markfarnan/yacht_hardware/README.md

# yacht_hardware
Various sensor circuits and boards for Yachts
