markfarnan/yacht_hardware/Multichannel_FET/FET_Multi.kicad_pcb

## KiCad design Multichannel_FET/FET_Multi.kicad_pcb (2020-11-30)

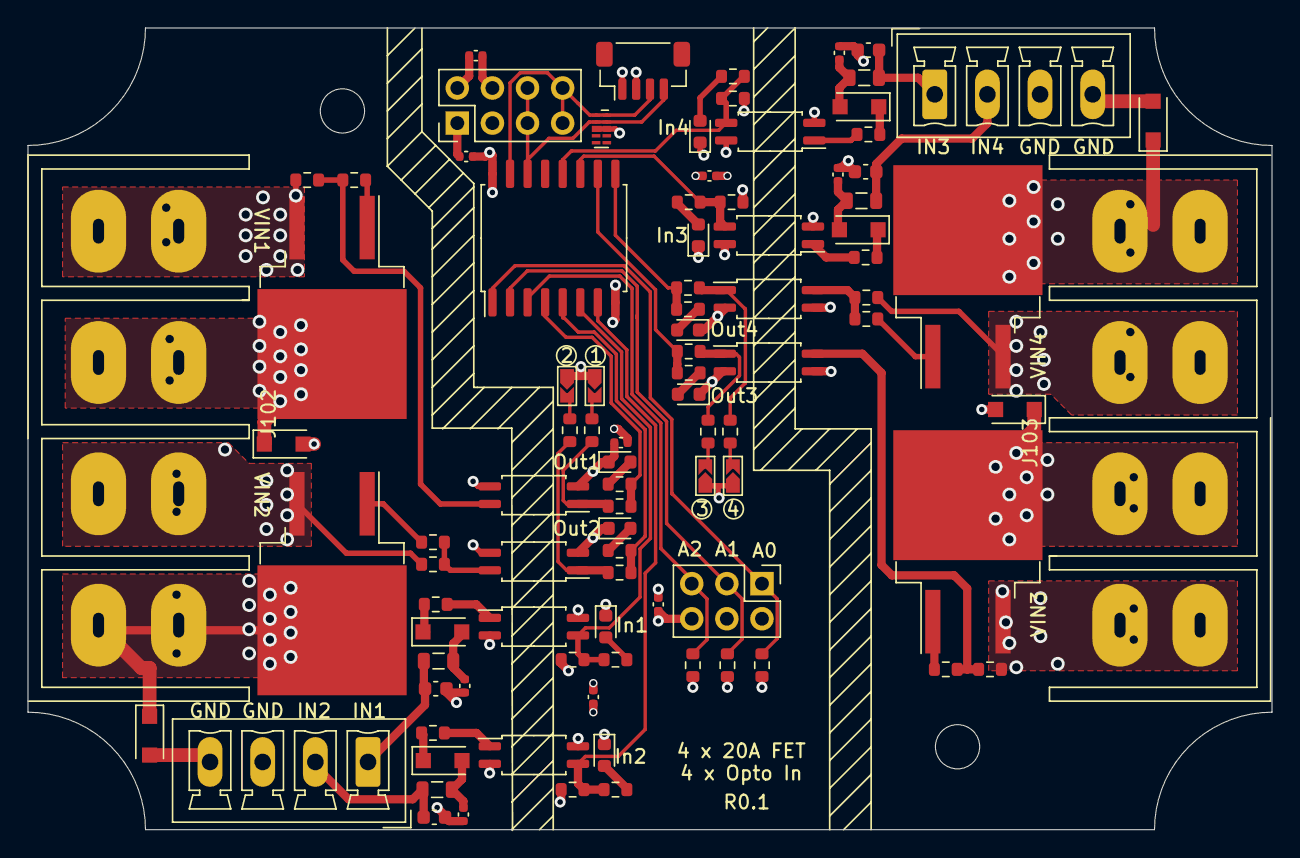
[picture p3: board FET_Multi.kicad_pcb from above]

Board: 4 copper layers, 90.0 x 58.0 mm, 96 parts (0 on the bottom side), 65 nets.

Parts:
C301, C303, C305, C307: 33pF; C_0402_1005Metric
C302, C304, C306, C308: 33pF/50V; C_0603_1608Metric
C1001, C1002, C1003, C1004, C1005, C1006: 100nF; C_0402_1005Metric
D101, D103, D105, D107, D301, D303, D305, D307: GREEN LED; LED_0603_1608Metric
D102, D104, D106, D108, D302, D304, D306, D308: SM4007PL; D_SOD-123F
FB301, FB302, FB303, FB304: GZ2012D101TF; L_0805_2012Metric
H1001, H1002: MountingHole; MountingHole_3.2mm_M3_Unplated
J101: I2C; PinHeader_2x04_P2.54mm_Vertical
J102, J103: DBT50G-9.5-4P; Connector_9.5mm_ScrewTerminal_4-Reversable
J104: Conn_01x04; JST_SH_BM04B-SRSS-TB_1x04-1MP_P1.00mm_Vertical
J106: ADDR; PinHeader_2x03_P2.54mm_Vertical
J107, J108, J109, J110: PU_ON; SolderJumper-2_P1.3mm_Open_TrianglePad_Narrow
J302, J303: MC 4; PhoenixContact_MCV_1,5_4-G-3.81_1x04_P3.81mm_Vertical
Q101, Q102, Q103, Q104: IRF5210STRLPBF; TO-263-2
R101, R105, R109, R113, R305, R307, R311, R312: 2k; R_0603_1608Metric
R102, R106, R110, R114: 220R; R_0603_1608Metric
R103, R107, R111, R115, R117, R118, R119: 10k; R_0603_1608Metric
R104, R108, R112, R116, R120, R121, R122, R123: 1k; R_0603_1608Metric
R301, R302, R303, R304, R306, R308, R309, R310: 2.2k; R_0603_1608Metric
U101, U102, U103, U104, U301, U302, U303, U304: EL3H7(C)(TA)-G; SOP-4_4.4x2.6mm_P1.27mm
U105: PCF8574T/3,518; SOIC-16W_7.5x10.3mm_P1.27mm
U106: RCLAMP0524P-N; Diodes_UDFN-10_1.0x2.5mm_P0.5mm

Connections:
+3V3: C1001.2, C1002.2, C1003.2, C1004.2, C1005.2, C1006.2, J101.3, J101.4, J104.2, J106.2, J106.4, J106.6, J107.1, J108.1, J109.1, J110.1, U105.16, U301.4, U302.4, U303.4, U304.4
/A0: J106.1, R119.1, U105.1
/A1: J106.3, R118.1, U105.2
/A2: J106.5, R117.1, U105.3
/GPIO0: R101.1, R102.2, U105.4
/GPIO1: R105.1, R106.2, U105.5
/GPIO4: R113.1, R114.2, U105.9
/GPIO5: R109.1, R110.2, U105.10
/Opto Input/ISO_IN_1: C302.1, FB301.1, J302.1
/Opto Input/ISO_IN_2: C304.1, FB302.1, J302.2
/Opto Input/ISO_IN_3: C306.1, FB303.1, J303.1
/Opto Input/ISO_IN_4: C308.1, FB304.1, J303.2
/SCL: J101.5, J101.6, J104.4, U105.14, U106.2, U106.9
/SDA: J101.7, J101.8, J104.3, U105.15, U106.1, U106.10
/VIN1: J102.1, Q101.3, R103.1
/VIN2: J102.3, Q102.3, R107.1
/VIN3: J103.1, Q103.3, R111.1
/VIN4: J103.3, Q104.3, R115.1
/VOUT1: D102.1, J102.2, Q101.2
/VOUT2: D104.1, J102.4, Q102.2
/VOUT3: D106.1, J103.2, Q103.2
/VOUT4: D108.1, J103.4, Q104.2
GND: C1001.1, C1002.1, C1003.1, C1004.1, C1005.1, C1006.1, D101.1, D103.1, D105.1, D107.1, D301.1, D303.1, D305.1, D307.1, J101.1, J101.2, J104.1, R117.2, R118.2, R119.2, R301.1, R303.1, R309.1, R310.1, U101.2, U102.2, U103.2, U104.2, U105.8, U106.3, U106.8
GND1: C301.2, C302.2, C303.2, C304.2, D102.2, D104.2, J302.3, J302.4, U101.3, U102.3, U301.2, U302.2
GND2: C305.2, C306.2, C307.2, C308.2, D106.2, D108.2, J303.3, J303.4, U103.3, U104.3, U303.2, U304.2
GPIO2: R301.2, R305.1, U105.6, U301.3
GPIO3: R303.2, R307.1, U105.7, U302.3
GPIO6: R309.2, R311.1, U105.11, U303.3
GPIO7: R310.2, R312.1, U105.12, U304.3
unnamed: C301.1, D302.2, FB301.2
unnamed: C303.1, D304.2, FB302.2
unnamed: C305.1, D306.2, FB303.2
unnamed: C307.1, D308.2, FB304.2
unnamed: D101.2, R101.2
unnamed: D103.2, R105.2
unnamed: D105.2, R109.2
unnamed: D107.2, R113.2
unnamed: D301.2, R305.2
unnamed: D302.1, R302.1
unnamed: D303.2, R307.2
unnamed: D304.1, R304.1
unnamed: D305.2, R311.2
unnamed: D306.1, R306.1
unnamed: D307.2, R312.2
unnamed: D308.1, R308.1
unnamed: J107.2, R120.1
unnamed: J108.2, R121.1
unnamed: J109.2, R122.1
unnamed: J110.2, R123.1
unnamed: Q101.1, R104.1
unnamed: Q102.1, R108.1
unnamed: Q103.1, R112.1
unnamed: Q104.1, R116.1
unnamed: R102.1, R120.2, U101.1
unnamed: R103.2, R104.2, U101.4
unnamed: R106.1, R121.2, U102.1
unnamed: R107.2, R108.2, U102.4
unnamed: R110.1, R123.2, U103.1
unnamed: R111.2, R112.2, U103.4
unnamed: R114.1, R122.2, U104.1
unnamed: R115.2, R116.2, U104.4
unnamed: R302.2, U301.1
unnamed: R304.2, U302.1
unnamed: R306.2, U304.1
unnamed: R308.2, U303.1
