markfarnan/yacht_hardware/Opto-Tacho/Opto-Tacho.kicad_pcb

## KiCad design Opto-Tacho/Opto-Tacho.kicad_pcb (2020-11-29)

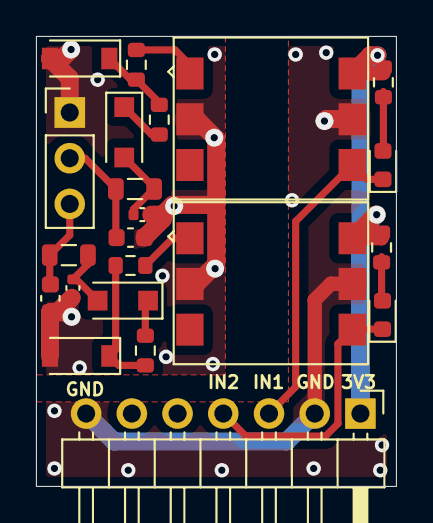
[picture p4: board Opto-Tacho.kicad_pcb from above]

Board: 2 copper layers, 20.0 x 25.0 mm, 22 parts (0 on the bottom side), 17 nets.

Parts:
C101, C103: 33pF; C_0402_1005Metric
C102, C104: 33pF/50V; C_0603_1608Metric
D101, D104: GREEN LED; LED_0603_1608Metric
D102, D105: MM1Z4V7B; D_SOD-123
D103, D106: SM4007PL; D_SOD-123F
FB101, FB102: GZ2012D101TF; L_0805_2012Metric
J101: Interface; PinHeader_1x07_P2.54mm_Horizontal
J901: Conn_01x03; PinHeader_1x03_P2.54mm_Vertical
R101, R103, R104, R106: 1k; R_0603_1608Metric
R102, R105: 330; R_0603_1608Metric
U101, U102: H11L1SR2M; SMT-6_6.4x8.5x2.54P

Connections:
+3V3: J101.1, R101.1, R104.1, U101.6, U102.6
/GPIO_1: D101.1, J101.3, U101.4
/GPIO_2: D104.1, J101.4, U102.4
/ISO_GND: C101.2, C102.2, C103.2, C104.2, D102.2, D105.2, J901.1, U101.2, U102.2
/ISO_IN_1: C102.1, FB101.1, J901.2
/ISO_IN_2: C104.1, FB102.1, J901.3
GND: J101.2, J101.7, U101.5, U102.5
unnamed: C101.1, D103.2, FB101.2
unnamed: C103.1, D106.2, FB102.2
unnamed: D101.2, R101.2
unnamed: D102.1, R102.1, R103.2
unnamed: D103.1, R103.1
unnamed: D104.2, R104.2
unnamed: D105.1, R105.1, R106.2
unnamed: D106.1, R106.1
unnamed: R102.2, U101.1
unnamed: R105.2, U102.1
