markfarnan/yacht_hardware/FT2232Breakout/FT2232Breakout.kicad_pcb

## KiCad design FT2232Breakout/FT2232Breakout.kicad_pcb (2020-11-28)

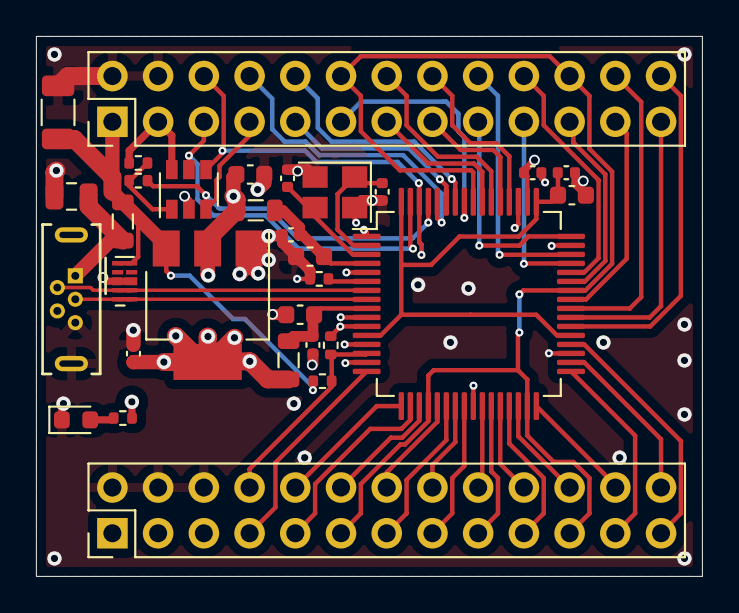
[picture p5: board FT2232Breakout.kicad_pcb from above]

Board: 4 copper layers, 37.0 x 30.0 mm, 31 parts (0 on the bottom side), 53 nets.

Parts:
C101, C103, C109: 4.7uF/16V; C_0603_1608Metric
C102: 4.7uF; C_0603_1608Metric
C104, C107: 30pf; C_0402_1005Metric
C105, C106, C108, C110, C305: 100nF; C_0402_1005Metric
C301: 10uF/50V; C_1206_3216Metric
C503: 1uF/50V; C_0805_2012Metric
D101: RED LED; LED_0603_1608Metric
FB101, FB102, FB401: GZ2012D601TF; L_0805_2012Metric
J101: USB_B_Micro; USB_Micro-B_Wuerth_614105150721_Vertical
J102: IO2; PinHeader_2x13_P2.54mm_Vertical
J103: IO1; PinHeader_2x13_P2.54mm_Vertical
R101, R104: 10k; R_0402_1005Metric
R102: 12k; R_0402_1005Metric
R103, R106: 2k; R_0402_1005Metric
R105: 15k; R_0402_1005Metric
U101: AMS1117-3.3; SOT-223-3_TabPin2
U102: 93LC56BT-I/OT; SOT-23-6
U103: FT2232HL; LQFP-64_10x10mm_P0.5mm
U402: RCLAMP0524P-N; Diodes_UDFN-10_1.0x2.5mm_P0.5mm
Y101: X322512MSB4SI; Crystal_SMD_3225-4Pin_3.2x2.5mm

Connections:
+3V3: C101.1, C108.1, C305.1, FB101.2, FB102.2, J102.3, J103.1, J103.3, J103.5, R101.1, R106.1, U101.2, U102.6, U103.50
+5V: C301.1, FB401.1, J102.1, R105.1, U101.3, U402.5, U402.6
/AC0: J103.18, U103.26
/AC1: J103.17, U103.27
/AC2: J103.20, U103.28
/AC3: J103.19, U103.29
/AC4: J103.22, U103.30
/AC5: J103.24, U103.32
/AC6: J103.23, U103.33
/AC7: J103.26, U103.34
/AD0: J103.7, U103.16
/AD1: J103.10, U103.17
/AD2: J103.9, U103.18
/AD3: J103.12, U103.19
/AD4: J103.14, U103.21
/AD5: J103.13, U103.22
/AD6: J103.16, U103.23
/AD7: J103.15, U103.24
/BC0: J102.17, U103.48
/BC1: J102.16, U103.52
/BC2: J102.15, U103.53
/BC3: J102.14, U103.54
/BC4: J102.13, U103.55
/BC5: J102.11, U103.57
/BC6: J102.10, U103.58
/BC7: J102.9, U103.59
/BD0: J102.26, U103.38
/BD1: J102.25, U103.39
/BD2: J102.24, U103.40
/BD3: J102.23, U103.41
/BD4: J102.21, U103.43
/BD5: J102.20, U103.44
/BD6: J102.19, U103.45
/BD7: J102.18, U103.46
/CLK: J102.6, U102.4, U103.62
/CS: J102.5, U102.5, U103.63
/DATA: J102.7, R103.1, U102.3, U103.61
/PWREN#: J102.8, U103.60
/RESET#: J103.8, R104.1, R105.2, U103.14
/SUSPEND#: J103.25, U103.36
/USB_D+: J101.3, U103.8, U402.1, U402.10
/USB_D-: J101.2, U103.7, U402.2, U402.9
/VBUS: C503.1, FB401.2, J101.1
/VCORE: C102.1, C105.1, U103.12, U103.37, U103.49, U103.64
/VIO: J102.12, J102.22, J103.11, J103.21, U103.20, U103.31, U103.42, U103.56
/VPHY: C103.1, C106.1, FB102.1, U103.4
/VPLL: C109.1, C110.1, FB101.1, U103.9
GND: C101.2, C102.2, C103.2, C104.1, C105.2, C106.2, C107.1, C108.2, C109.2, C110.2, C301.2, C305.2, C503.2, D101.1, J101.5, J101.6, J102.2, J102.4, J103.2, J103.4, J103.6, R102.2, R104.2, U101.1, U102.2, U103.1, U103.5, U103.10, U103.11, U103.13, U103.15, U103.25, U103.35, U103.47, U103.51, U402.3, U402.8, Y101.2, Y101.4
unnamed: C104.2, U103.2, Y101.1
unnamed: C107.2, U103.3, Y101.3
unnamed: D101.2, R106.2
unnamed: R101.2, R103.2, U102.1
unnamed: R102.1, U103.6
