markfarnan/yacht_hardware/FET_Driver/FET_Driver.kicad_pcb

## KiCad design FET_Driver/FET_Driver.kicad_pcb (2020-11-28)

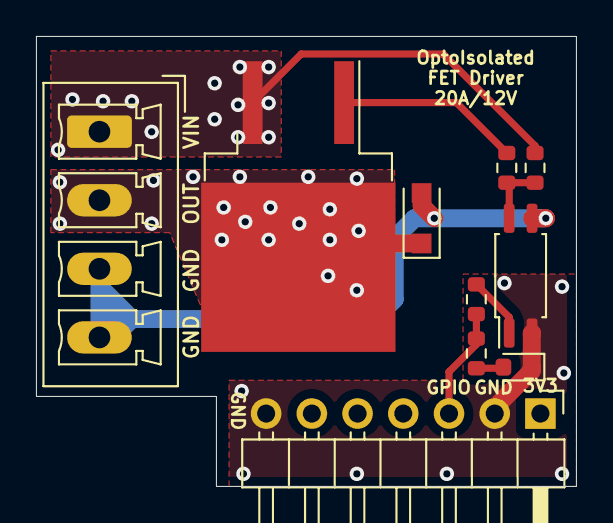
[picture p6: board FET_Driver/FET_Driver.kicad_pcb from above]

Board: 2 copper layers, 30.0 x 25.0 mm, 10 parts (0 on the bottom side), 9 nets.

Parts:
D101: SM4007PL; D_SOD-123F
D102: GREEN LED; LED_0603_1608Metric
J101: Interface; PinHeader_1x07_P2.54mm_Horizontal
J102: Out; PhoenixContact_MCV_1,5_4-G-3.81_1x04_P3.81mm_Vertical
Q101: IRF5210STRLPBF; TO-263-2
R101: 10k; R_0603_1608Metric
R102, R103: 1k; R_0603_1608Metric
R901: 220R; R_0603_1608Metric
U101: EL3H7(C)(TA)-G; SOP-4_4.4x2.6mm_P1.27mm

Connections:
/GPIO: J101.3, R103.1, R901.2
/ISO_GND: D101.2, J102.3, J102.4, U101.3
/ISO_OUT: D101.1, J102.2, Q101.2
/ISO_VIN: J102.1, Q101.3, R101.1
GND: D102.1, J101.2, J101.7, U101.2
unnamed: D102.2, R103.2
unnamed: Q101.1, R102.1
unnamed: R101.2, R102.2, U101.4
unnamed: R901.1, U101.1
