markfarnan/yacht_hardware/VibrationSense/VibrationSensor.kicad_pcb

## KiCad design VibrationSense/VibrationSensor.kicad_pcb (2020-11-28)

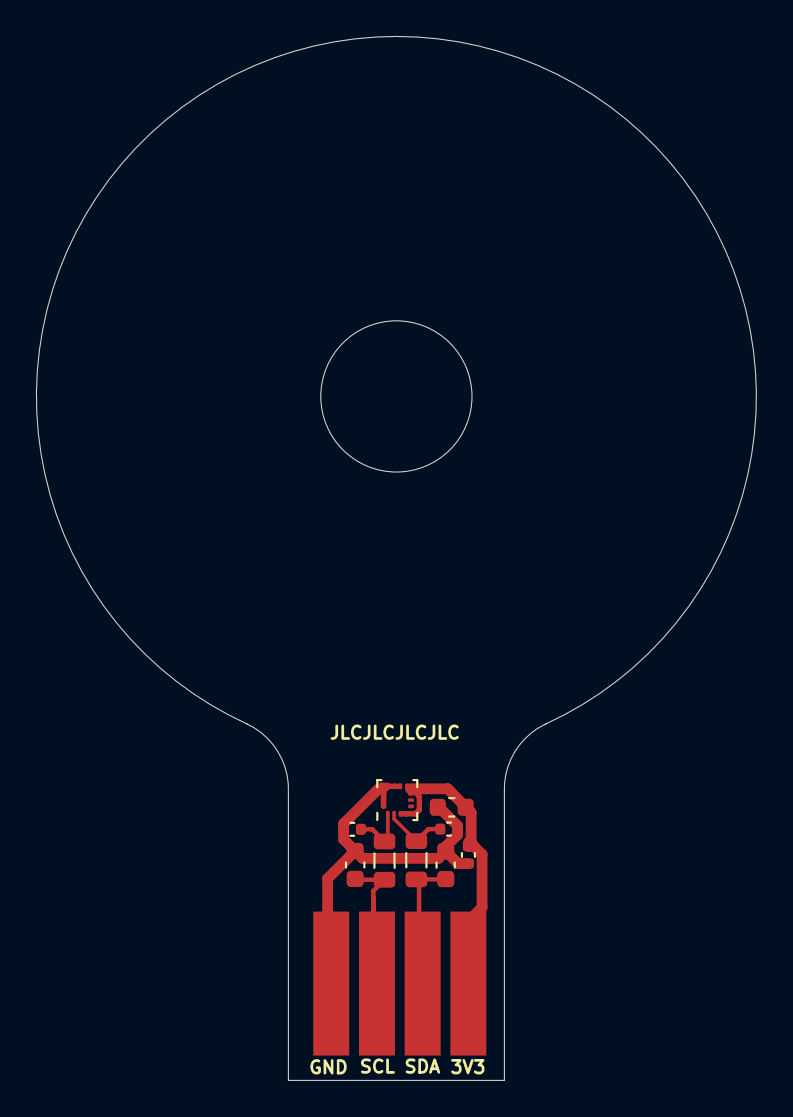
[picture p7: board VibrationSensor.kicad_pcb from above]

Board: 2 copper layers, 40.0 x 58.0 mm, 11 parts (0 on the bottom side), 6 nets.

Parts:
C101: 4.7uF; C_0603_1608Metric
C102, C103: 33pF/50V; C_0603_1608Metric
C104, C105: 33pF; C_0402_1005Metric
C305: 100nF; C_0402_1005Metric
FB101, FB102: GZ2012D101TF; L_0805_2012Metric
H101: MountingHole; MountingHole_8.4mm_M8
J101: Interface; Header_1x04_P2.54mm_SurfaceWires
U101: LIS2DH12TR; LGA-14_2x2mm_P0.35mm_LayoutBorder3x4y

Connections:
+3V3: C101.2, C305.2, J101.1, U101.3, U101.4, U101.7, U101.8
/SCL: C103.1, FB102.1, J101.3
/SDA: C102.1, FB101.1, J101.2
GND: C101.1, C102.2, C103.2, C104.2, C105.2, C305.1, J101.4, U101.9, U101.10, U101.11, U101.12, U101.13, U101.14
unnamed: C104.1, FB101.2, U101.2
unnamed: C105.1, FB102.2, U101.1
