markfarnan/yacht_hardware/Tank_Sender/Tank_Sender.kicad_pcb

## KiCad design Tank_Sender/Tank_Sender.kicad_pcb (2020-11-27)

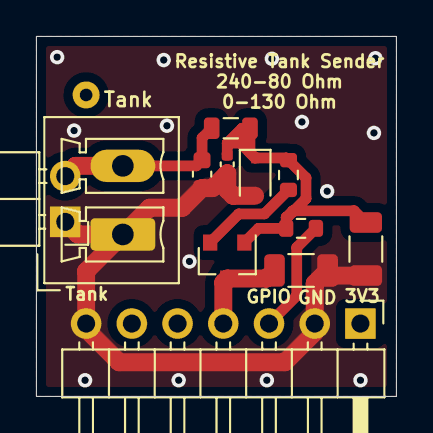
[picture p8: board Tank_Sender.kicad_pcb from above]

Board: 2 copper layers, 20.0 x 20.0 mm, 12 parts (0 on the bottom side), 6 nets.

Parts:
C101, C102: 10uF/50V; C_1206_3216Metric
C103: 33pF; C_0402_1005Metric
C104: 33pF/50V; C_0603_1608Metric
D101: KDZ3.3V-RTK/P; D_SOD-323
FB101: GZ2012D101TF; L_0805_2012Metric
J101: Interface; PinHeader_1x07_P2.54mm_Horizontal
J102: TANK; PinHeader_1x02_P2.54mm_Horizontal
J103: TANK; PhoenixContact_MCV_1,5_2-G-3.81_1x02_P3.81mm_Vertical
R101: 2K; R_0603_1608Metric
R102: 470; R_0603_1608Metric
U101: H7550-H#; SOT-23

Connections:
/GPIO_AD: J101.3, R101.1
/Tank: C104.1, FB101.1, J102.2, J103.2
/VIN_PROT: C101.1, J101.4, U101.3
GND: C101.2, C102.2, C103.2, C104.2, D101.2, J101.2, J101.7, J102.1, J103.1
unnamed: C102.1, C103.1, D101.1, FB101.2, R101.2, R102.2, U101.1
unnamed: R102.1, U101.2
