markfarnan/yacht_hardware/FET_Driver_Sense/FET_Driver.kicad_pcb

## KiCad design FET_Driver_Sense/FET_Driver.kicad_pcb (2020-11-27)

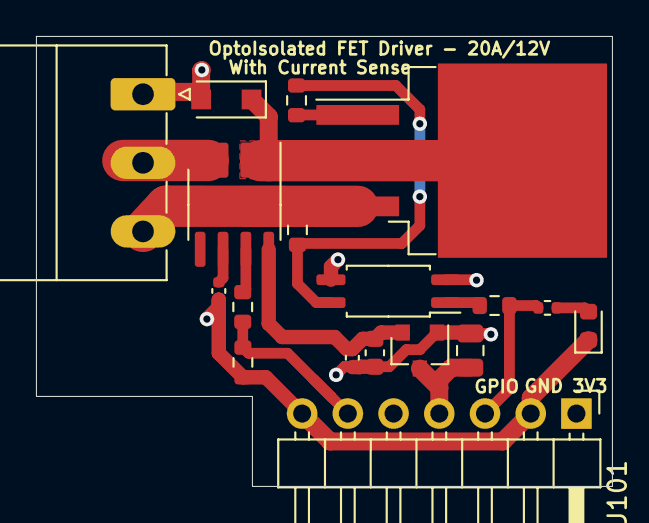
[picture p9: board FET_Driver_Sense/FET_Driver.kicad_pcb from above]

Board: 2 copper layers, 32.0 x 25.0 mm, 18 parts (0 on the bottom side), 15 nets.

Parts:
C101, C102: 100nF; C_0402_1005Metric
C603: 2.2uF/50V; C_0805_2012Metric
C605: 2.2uF/16V; C_0603_1608Metric
D101: SM4007PL; D_SOD-123F
D102: GREEN LED; LED_0603_1608Metric
J101: Interface; PinHeader_1x07_P2.54mm_Horizontal
J102: Out; PhoenixContact_MC_1,5_3-G-3.81_1x03_P3.81mm_Horizontal
Q101: IRF5210STRLPBF; TO-263-2
R101, R103: 10k; R_0603_1608Metric
R102: 1k; R_0603_1608Metric
R104: 2k; R_0603_1608Metric
R105: 2k; R_0402_1005Metric
R901: 220R; R_0603_1608Metric
U101: EL3H7(C)(TA)-G; SOP-4_4.4x2.6mm_P1.27mm
U102: ACS712ELCTR-20A-T; SOIC-8_3.9x4.9mm_P1.27mm
U603: H7550-H#; SOT-23

Connections:
+5V: C101.2, C605.1, U102.8, U603.2
/GPIO: J101.3, R105.1, R901.2
/ISO_GND: D101.2, J102.1, U101.3
/ISO_OUT: J102.2, U102.3, U102.4
/ISO_OUT_RAW: D101.1, Q101.2, U102.1, U102.2
/ISO_VIN: J102.3, Q101.3, R101.1
/Sense: J101.6, R103.1, R104.2
/VIN: C603.1, J101.4, U603.3
GND: C101.1, C102.2, C603.2, C605.2, D102.1, J101.2, J101.7, R103.2, U101.2, U603.1
unnamed: C102.1, U102.6
unnamed: D102.2, R105.2
unnamed: Q101.1, R102.1
unnamed: R101.2, R102.2, U101.4
unnamed: R104.1, U102.7
unnamed: R901.1, U101.1
