markfarnan/yacht_hardware/AC_Current_Transformer/AC_Current_Transformer.kicad_pcb

## KiCad design AC_Current_Transformer/AC_Current_Transformer.kicad_pcb (2020-11-21)

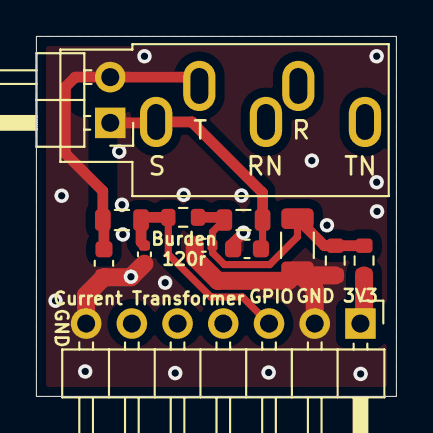
[picture p10: board AC_Current_Transformer.kicad_pcb from above]

Board: 2 copper layers, 20.0 x 20.0 mm, 13 parts (0 on the bottom side), 6 nets.

Parts:
C101: 10uf/50V; C_1206_3216Metric
C102, C103: 33pF; C_0402_1005Metric
C104, C105: 33pF/50V; C_0603_1608Metric
FB101, FB102: GZ2012D101TF; L_0805_2012Metric
J101: Interface; PinHeader_1x07_P2.54mm_Horizontal
J102: AudioJack3; Jack_3.5mm_CUI_SJ1-3535NG_Horizontal
J103: Conn_01x02; PinHeader_1x02_P2.54mm_Horizontal
R101: 120; R_0603_1608Metric
R102, R103: 10k; R_0603_1608Metric

Connections:
+3V3: J101.1, R102.1
/GPIO: C103.1, FB101.2, J101.3, R101.1
GND: C101.2, C102.2, C103.2, C104.2, C105.2, J101.2, J101.7, R103.2
unnamed: C101.1, C102.1, FB102.2, R101.2, R102.2, R103.1
unnamed: C104.1, FB101.1, J102.T, J103.2
unnamed: C105.1, FB102.1, J102.S, J103.1
