markfarnan/yacht_hardware/SH-ESP32-PowerFET/SH-ESP32-PowerFET3.kicad_pcb

## KiCad design SH-ESP32-PowerFET/SH-ESP32-PowerFET3.kicad_pcb (2020-12-24)

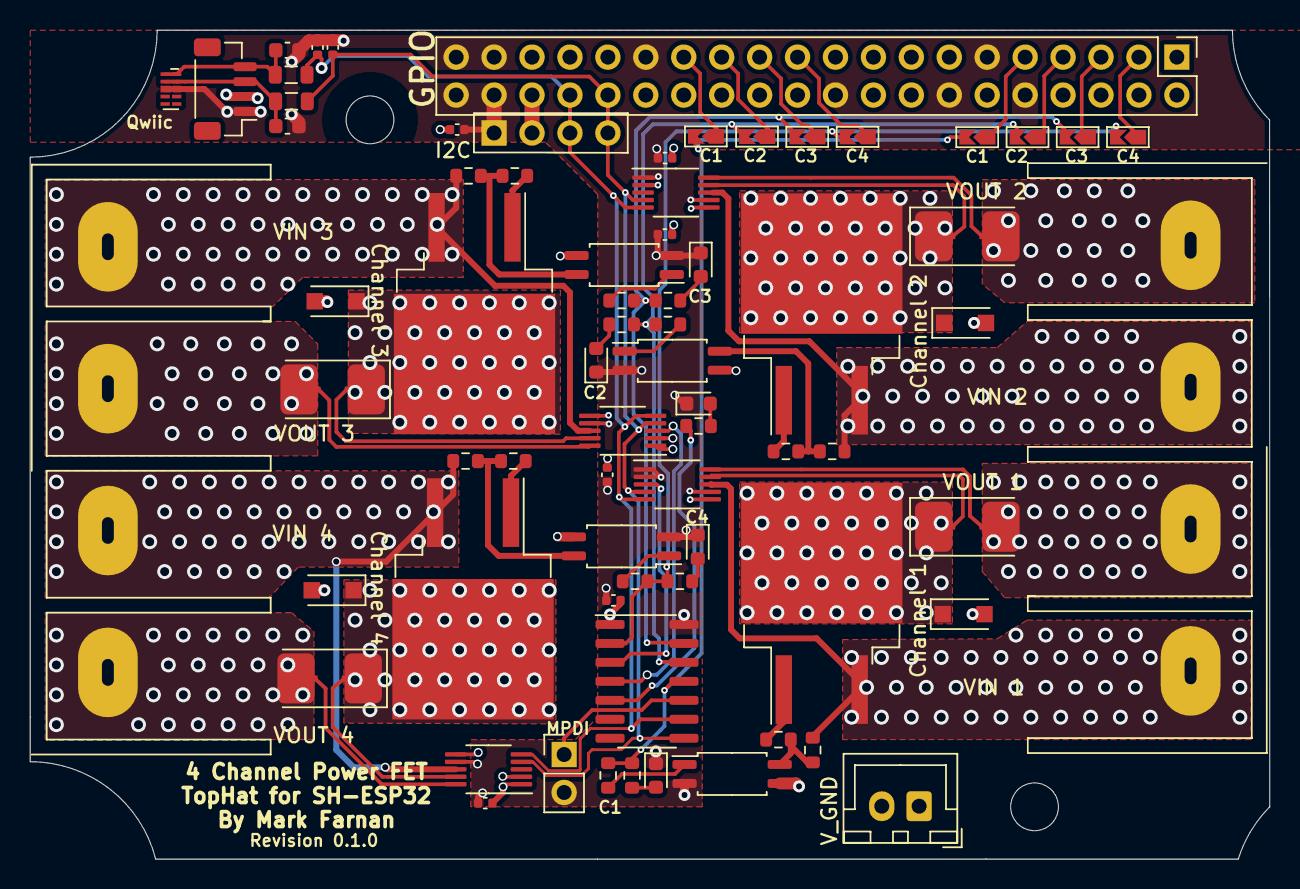
[picture p11: board SH-ESP32-PowerFET3.kicad_pcb from above]

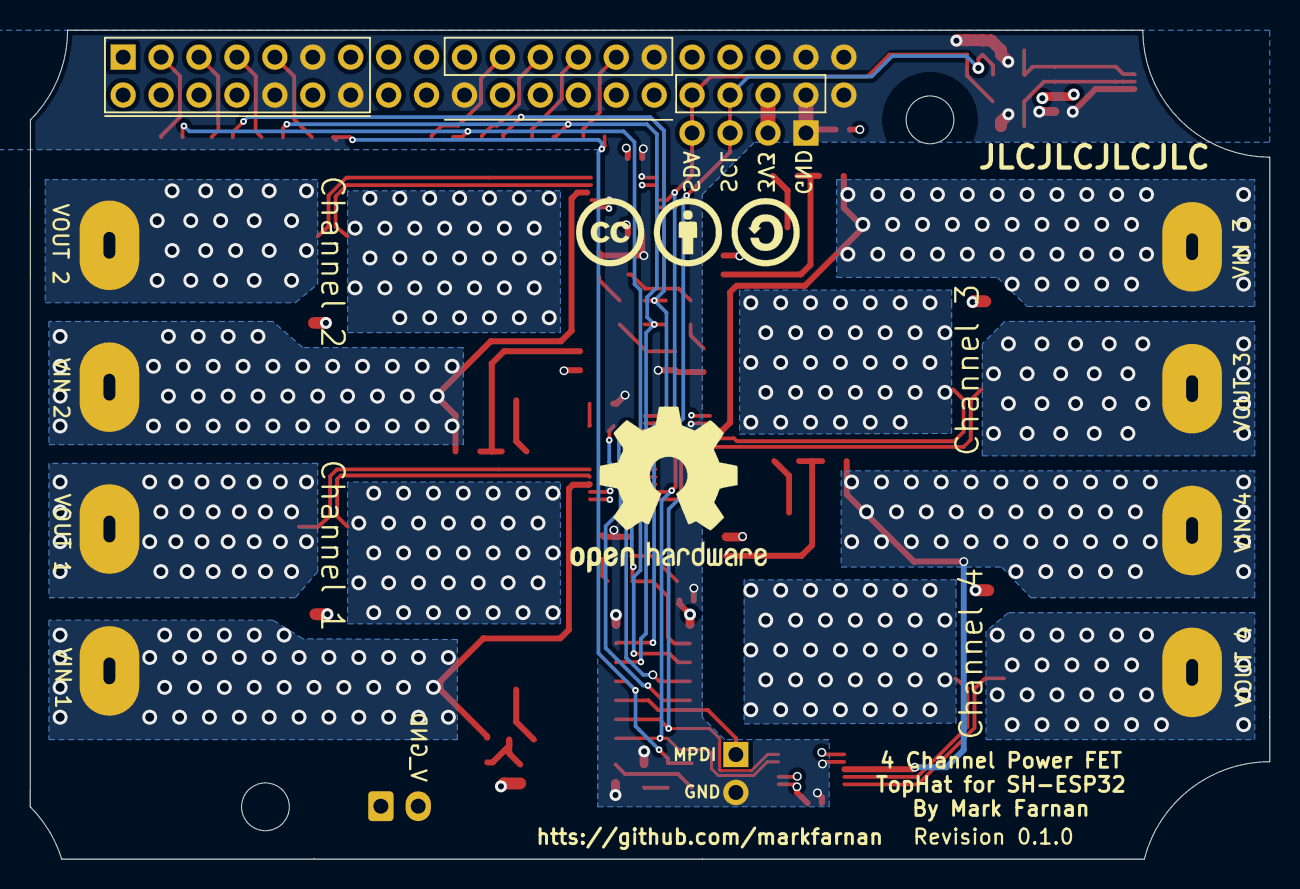
[picture p12: board SH-ESP32-PowerFET3.kicad_pcb from below]

Board: 4 copper layers, 83.0 x 55.5 mm, 75 parts (2 on the bottom side), 52 nets.

Parts:
C102, C103: 33pF/50V; C_0603_1608Metric
C105, C106: 33pF; C_0402_1005Metric
C201, C202, C203, C204, C205, C206: 100nF; C_0402_1005Metric
D101: RED LED; LED_0603_1608Metric
D301, D302, D303, D307: BLUE LED; LED_0603_1608Metric
D304, D305, D306, D308: SM4007PL; D_SOD-123F
FB102, FB103: GZ2012D101TF; L_0805_2012Metric
H201, H202: MountingHole; MountingHole_3.2mm_M3_Unplated
J101: DBT50G-9.5-4P; Connector_9.5mm_ScrewTerminal_4
J102: DBT50G-9.5-2P; Connector_9.5mm_ScrewTerminal_4
J103: GPIO; PinHeader_2x20_P2.54mm_Vertical
J104: Qwiic; JST_SH_BM04B-SRSS-TB_1x04-1MP_P1.00mm_Vertical
J105: MPDI; PinHeader_1x02_P2.54mm_Vertical
J106: Conn_01x04; PinHeader_1x04_P2.54mm_Vertical-ShrunkCY
J301: VIN_GND1; JST_XH_B2B-XH-A_1x02_P2.50mm_Vertical
JP101, JP102, JP103, JP104, JP105, JP106, JP107, JP108: Solder Jumper; SolderJumper-2_P1.3mm_Open_TrianglePad_Narrow
LOGO_CC: LOGO; cc-by-sa_silkscreen
OSHW: OSHW-Logo2_14.6x12mm_SilkScreen
Q301, Q302, Q303, Q304: IRF5210STRLPBF; TO-263-2
R101, R301, R302, R303, R316: 2k; R_0603_1608Metric
R304, R305, R306, R317: 220R; R_0603_1608Metric
R307, R308, R309, R318: 10k; R_0603_1608Metric
R310, R311, R312, R319: 1k; R_0603_1608Metric
R313, R314, R315, R320: 0.002ohm/3W; D_2512_Shunt
U101: ATtiny1614-SSNR; SOIC-14_3.9x8.7mm_P1.27mm
U301, U302, U303, U307: EL3H7(C)(TA)-G; SOP-4_4.4x2.6mm_P1.27mm
U304, U305, U306, U308: INA226AIDGSR; VSSOP-10_3x3mm_P0.5mm
U701: RCLAMP0524P-N; Diodes_UDFN-10_1.0x2.5mm_P0.5mm

Connections:
+3V3: C201.2, C202.2, C203.2, C204.2, C205.2, C206.2, J103.13, J103.19, J103.35, J103.36, J104.2, J106.2, U101.1, U304.1, U304.6, U305.2, U305.6, U306.6, U308.1, U308.2, U308.6
/FET/VOUT1: D306.1, Q303.2, R315.1, R315.2, U306.9
/FET/VOUT2: D305.1, Q302.2, R314.1, R314.2, U305.9
/FET/VOUT3: D304.1, Q301.2, R313.1, R313.2, U304.9
/FET/VOUT4: D308.1, Q304.2, R320.1, R320.2, U308.9
/IO12: J103.21, JP108.1
/IO13: J103.25, JP106.1
/IO14: J103.23, JP107.1
/IO15: J103.27, JP105.1
/IO18: J103.5, JP103.1
/IO21: J103.3, JP104.1
/IO26: J103.7, JP102.1
/IO27: J103.9, JP101.1
/SCL_CONN: C103.1, FB103.1, J104.4, U701.1, U701.10
/SDA_CONN: C102.1, FB102.1, J104.3, U701.2, U701.9
ALERT1: U101.3, U306.3
ALERT4: U101.4, U304.3
FETOUT_01: JP101.2, JP105.2, R303.1, R306.2, U101.11
FETOUT_02: JP102.2, JP106.2, R302.1, R305.2, U101.12
FETOUT_03: JP103.2, JP107.2, R301.1, R304.2, U101.13
FETOUT_04: JP104.2, JP108.2, R316.1, R317.2, U101.2
GND: C102.2, C103.2, C105.2, C106.2, C201.1, C202.1, C203.1, C204.1, C205.1, C206.1, D101.1, D301.1, D302.1, D303.1, D307.1, J103.10, J103.11, J103.14, J103.20, J103.29, J103.37, J103.38, J103.39, J103.40, J104.1, J105.2, J106.1, U101.14, U301.2, U302.2, U303.2, U304.2, U304.7, U305.1, U305.7, U306.1, U306.2, U306.7, U307.2, U308.7, U701.3, U701.8
GND1: D304.2, D305.2, D306.2, D308.2, J301.2, U301.3, U302.3, U303.3, U307.3
unnamed: D101.2, R101.2
unnamed: D301.2, R301.2
unnamed: D302.2, R302.2
unnamed: D303.2, R303.2
unnamed: D307.2, R316.2
unnamed: J105.1, U101.10
unnamed: Q301.1, R310.1
unnamed: Q302.1, R311.1
unnamed: Q303.1, R312.1
unnamed: Q304.1, R319.1
unnamed: R101.1, U101.5
unnamed: R304.1, U301.1
unnamed: R305.1, U302.1
unnamed: R306.1, U303.1
unnamed: R307.2, R310.2, U301.4
unnamed: R308.2, R311.2, U302.4
unnamed: R309.2, R312.2, U303.4
unnamed: R317.1, U307.1
unnamed: R318.2, R319.2, U307.4
SCL: C106.1, FB103.2, J103.34, J106.3, U101.9, U304.5, U305.5, U306.5, U308.5
SDA: C105.1, FB102.2, J103.32, J106.4, U101.8, U304.4, U305.4, U306.4, U308.4
VIN_01: J101.1, Q303.3, R309.1, U306.8
VIN_02: J101.3, Q302.3, R308.1, U305.8
VIN_03: J102.1, Q301.3, R307.1, U304.8
VIN_04: J102.3, Q304.3, R318.1, U308.8
VOUT_01: J101.2, R315.3, R315.4, U306.10
VOUT_02: J101.4, R314.3, R314.4, U305.10
VOUT_03: J102.2, R313.3, R313.4, U304.10
VOUT_04: J102.4, R320.3, R320.4, U308.10
