markfarnan/yacht_hardware/SH-ESP32-PowerFET/SH-ESP32-PowerFET2.kicad_pcb

## KiCad design SH-ESP32-PowerFET/SH-ESP32-PowerFET2.kicad_pcb (2020-12-03)

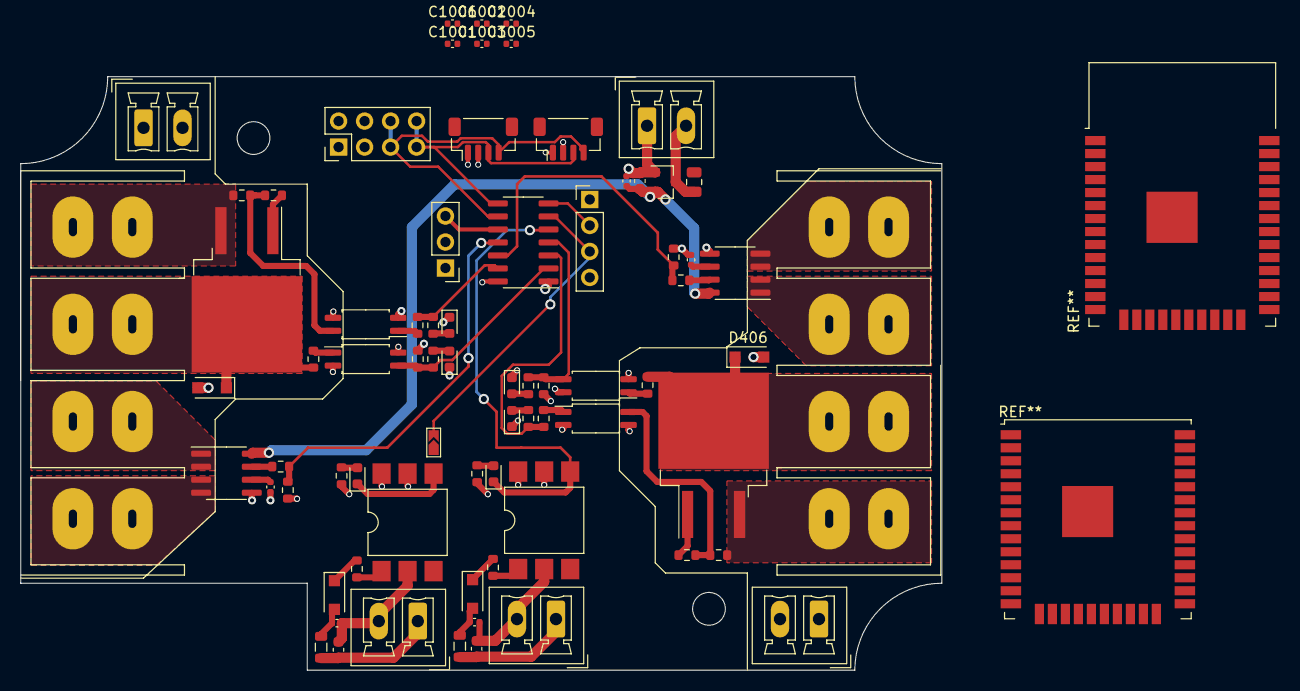
[picture p13: board SH-ESP32-PowerFET2.kicad_pcb from above]

Board: 4 copper layers, 90.0 x 58.0 mm, 76 parts (0 on the bottom side), 55 nets.

Parts:
C301, C303: 33pF; C_0402_1005Metric
C302, C304: 33pF/50V; C_0603_1608Metric
C501: 2.2uF/50V; C_0805_2012Metric
C502, C503: 1nF; C_0402_1005Metric
C504: 2.2uF/16V; C_0603_1608Metric
C505, C1001, C1002, C1003, C1004, C1005, C1006: 100nF; C_0402_1005Metric
D301, D303, D403, D404: GREEN LED; LED_0603_1608Metric
D302, D304, D405, D406: SM4007PL; D_SOD-123F
D401, D402: BLUE LED; LED_0603_1608Metric
FB301, FB302: GZ2012D101TF; L_0805_2012Metric
H1001, H1002: MountingHole; MountingHole_3.2mm_M3_Unplated
J101: I2C; PinHeader_2x04_P2.54mm_Vertical
J102: 1-WIRE; PinHeader_1x04_P2.54mm_Vertical
J103: UPDI; PinHeader_1x03_P2.54mm_Vertical
J104, J107: QWIIC; JST_SH_BM04B-SRSS-TB_1x04-1MP_P1.00mm_Vertical
J105, J106: DBT50G-9.5-4P; Connector_9.5mm_ScrewTerminal_4-Reversable
J301, J302: OptoIn; PhoenixContact_MCV_1,5_2-G-3.81_1x02_P3.81mm_Vertical
J401, J402, J501: VIN; PhoenixContact_MCV_1,5_2-G-3.81_1x02_P3.81mm_Vertical
JP101: Jumper_NO_Small; SolderJumper-2_P1.3mm_Open_TrianglePad_Narrow
Q401, Q402: IRF5210STRLPBF; TO-263-2
R301, R303, R411, R412: 1k; R_0603_1608Metric
R302, R304: 3k; R_0603_1608Metric
R401, R402, R407, R408: 2k; R_0603_1608Metric
R403, R405, R413, R414: 2.2k; R_0603_1608Metric
R404, R406: 220R; R_0603_1608Metric
R409, R410, R501, R502: 10k; R_0603_1608Metric
R503, R504: 470; R_0603_1608Metric
U101: ATtiny1614-SS; SOIC-14_3.9x8.7mm_P1.27mm
U301, U302: H11L1SR2M; SMDIP-6_W9.53mm
U401, U402, U403, U404: EL3H7(C)(TA)-G; SOP-4_4.4x2.6mm_P1.27mm
U501: H7550-H#; SOT-23
U502, U503: ACS712ELCTR-20A-T; SOIC-8_3.9x4.9mm_P1.27mm

Connections:
+3V3: C1001.2, C1002.2, C1003.2, C1004.2, C1005.2, C1006.2, J101.3, J101.4, J102.1, J103.1, J104.2, J107.2, R301.1, R303.1, U101.1, U301.6, U302.6, U403.4, U404.4
+5V: C504.1, C505.2, U501.2, U502.8, U503.8
/Opto Input/ISO_GND_1: C301.2, C302.2, J301.2, U301.2
/Opto Input/ISO_GND_2: C303.2, C304.2, J302.2, U302.2
/Opto Input/ISO_IN_1: C302.1, FB301.1, J301.1
/Opto Input/ISO_IN_2: C304.1, FB302.1, J302.1
/RxD: J102.3, JP101.2, U101.6
/SCL: J101.5, J101.6, J104.4, J107.4, U101.9
/SDA: J101.7, J101.8, J104.3, J107.3, U101.8
/TxD_1-WIRE: J102.2, U101.7
/UPDI: J103.3, U101.10
FETOUT_01: R401.1, R404.2, U101.13
FETOUT_02: R402.1, R406.2, U101.3
FETSENSE_01: R403.2, R407.1, U101.2, U403.3
FETSENSE_02: R405.2, R408.1, U101.4, U404.3
GND: C501.2, C502.2, C503.2, C504.2, C505.1, C1001.1, C1002.1, C1003.1, C1004.1, C1005.1, C1006.1, D401.1, D402.1, D403.1, D404.1, J101.1, J101.2, J102.4, J103.2, J104.1, J107.1, J501.1, R403.1, R405.1, R501.2, R502.2, U101.14, U301.5, U302.5, U401.2, U402.2, U501.1, U502.5, U503.5
GND1: D405.2, J402.1, J402.2, U401.3, U403.2
GND2: D406.2, J401.1, J401.2, U402.3, U404.2
unnamed: C301.1, D302.2, FB301.2
unnamed: C303.1, D304.2, FB302.2
unnamed: C501.1, J501.2, U501.3
unnamed: C502.1, U502.6
unnamed: C503.1, U503.6
unnamed: D301.2, R301.2
unnamed: D302.1, R302.1
unnamed: D303.2, R303.2
unnamed: D304.1, R304.1
unnamed: D401.2, R401.2
unnamed: D402.2, R402.2
unnamed: D403.2, R407.2
unnamed: D404.2, R408.2
unnamed: Q401.1, R411.1
unnamed: Q402.1, R412.1
unnamed: R302.2, U301.1
unnamed: R304.2, U302.1
unnamed: R404.1, U401.1
unnamed: R406.1, U402.1
unnamed: R409.2, R411.2, U401.4
unnamed: R410.2, R412.2, U402.4
unnamed: R413.2, U403.1
unnamed: R414.2, U404.1
unnamed: R503.1, U502.7
unnamed: R504.1, U503.7
OPTO_IN_1: D301.1, U101.5, U301.4
OPTO_IN_2: D303.1, JP101.1, U302.4
SENSE_VINeg_01: J105.4, U502.3, U502.4
SENSE_VINeg_02: J106.4, U503.3, U503.4
SENSE_VIPos_01: J105.3, U502.1, U502.2
SENSE_VIPos_02: J106.3, U503.1, U503.2
VIN_01: J105.1, Q401.3, R409.1
VIN_02: J106.1, Q402.3, R410.1
VOUT_01: D405.1, J105.2, Q401.2, R413.1
VOUT_02: D406.1, J106.2, Q402.2, R414.1
VSENSE_01: R501.1, R503.2, U101.11
VSENSE_02: R502.1, R504.2, U101.12
