markfarnan/yacht_hardware/AC_Current_Transformer/AC_Current_Transformer-A.kicad_pcb

## KiCad design AC_Current_Transformer/AC_Current_Transformer-A.kicad_pcb (2020-11-20)

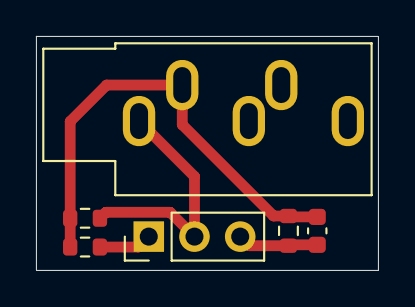
[picture p14: board AC_Current_Transformer-A.kicad_pcb from above]

Board: 2 copper layers, 19.0 x 13.0 mm, 6 parts (0 on the bottom side), 4 nets.

Parts:
C101: CP; C_0603_1608Metric
J101: AudioJack3; Jack_3.5mm_CUI_SJ1-3535NG_Horizontal
J102: Conn_01x03_Male; PinHeader_1x03_P2.54mm_Vertical
R101: 120; R_0603_1608Metric
R102, R103: 12; R_0603_1608Metric

Connections:
+3V3: J102.1, R102.1
GND: C101.2, J102.3, R103.2
unnamed: C101.1, J101.T, R101.2, R102.2, R103.1
unnamed: J101.S, J102.2, R101.1
