markfarnan/yacht_hardware/(commit log)

2020-11-20 Initial version with AC Current Transformer, MiniHatProt and Tanksender sensor adapters
    [AC_Current_Transformer-A.kicad_pcb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]
2020-11-20 Standardize on 20mm x 20mm boards with 7pin header
    [AC_Current_Transformer.kicad_pcb, MiniHat-T.kicad_pcb, Tank_Sender.kicad_pcb]
2020-11-21 New GND Pin. Added PI Filters to all inputs. Refined Layout
    [AC_Current_Transformer-B_Cu.gbr, AC_Current_Transformer-B_Mask.gbr, AC_Current_Transformer-B_SilkS.gbr, AC_Current_Transformer-Edge_Cuts.gbr, AC_Current_Transformer-F_Cu.gbr, AC_Current_Transformer-F_Mask.gbr, AC_Current_Transformer-F_SilkS.gbr, AC_Current_Transformer-job.gbrjob]
2020-11-21 FET Driver with Current Sense
    [FET_Driver.kicad_pcb, FET_Driver.sch]
2020-11-22 Opto Tacho (Schmidtt), Fixes to FET_Driver_Sense
    [FET_Driver.kicad_pcb, FET_Driver.sch, Opto-Tacho.kicad_pcb, Opto-Tacho.sch]
2020-11-24 Fix Libraries
    [FET_Driver.sch]
2020-11-24 Fix Symbol Libraries
    [FET_Driver.sch, Tank_Sender.sch]
2020-11-27 Production Tidyup - LCSC Part Numbers
    [IOHeader.sch, Opto-Tacho.kicad_pcb, Opto-Tacho.sch, PCB.sch]
2020-11-27 FET Driver - LCSC Parts tidy up
    [FET_Driver.kicad_pcb, FET_Driver.sch]
2020-11-27 Opto - LCSC Parts added
    [Tank_Sender.kicad_pcb, Tank_Sender.sch]
2020-11-27 Vibration Sensor - Initial Version 0.1
    [VibrationSensor.kicad_pcb, VibrationSensor.sch]
2020-11-27 Add LCSC part to Accelerometer
    [VibrationSensor.sch]
2020-11-28 Change to LIS2DH12 (from HH). DH has higher sampling rate, and is cheaper.
    [VibrationSensor.kicad_pcb, VibrationSensor.sch]
2020-11-28 Fix Resistor sizes to all are 603
    [Opto-Tacho.kicad_pcb, Opto-Tacho.sch]
2020-11-28 Re-arrange FET Driver PCB for better High current tracks
    [FET_Driver.kicad_pcb, FET_Driver.sch]
2020-11-28 Change FET VIN/OUT connector to 4 Pin to reduce stock parts
    [FET_Driver.kicad_pcb, FET_Driver.sch]
2020-11-28 Initial Version - FT2232HL Breakout board
    [FT2232Breakout.kicad_pcb, FT2232Breakout.sch]
2020-11-29 Add file fixer script for FET Driver
    (cherry picked from commit 5fe6a2fc87ed3db5ff3dbfc584127ee4adedae34)
2020-11-29 Fix Footprint center for Opto
    [Opto-Tacho.kicad_pcb]
2020-11-29 FT2232 Proto board
    [FT2232Proto.kicad_pcb, FT2232Proto.sch]
2020-11-29 Opto-Tach - Change Opto's to SMD part
    [Opto-Tacho.kicad_pcb]
2020-11-30 Initial Commit - Multichannel FET
    [FET.sch, FET_Multi.kicad_pcb, FET_Multi.sch, OptoInput.sch, PCB.sch]
2020-11-30 Silkscreen Updates - MultiChannel_FET
    [FET_Multi.kicad_pcb]
2020-11-30 100x68x50 Box board Blank
    [PCB_Template_100x68x50_box.kicad_pcb]
2020-12-03 SH-ESP32 / I2C 4Ch PowerFET board - Initial
    [Current_Sense.sch, FET.sch, OptoInput.sch, PCB.sch, SH-ESP32-PowerFET.csv, SH-ESP32-PowerFET.kicad_pcb, SH-ESP32-PowerFET.sch, SH-ESP32-PowerFET2.kicad_pcb]
2020-12-03 Updated Shunt Part number
    [FET.sch, SH-ESP32-PowerFET.csv, SH-ESP32-PowerFET.kicad_pcb, SH-ESP32-PowerFET.sch]
2020-12-24 Major Refactor - Based on new requirments from Karl and feedback. - Made from latest blank with more PCB area, and new interconnect positions for I2C, GPIO etc - Removed opto couplers - I2C now isola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
    [FET.sch, PCB.sch, SH-ESP32-PowerFET.kicad_pcb, SH-ESP32-PowerFET.sch, SH-ESP32-PowerFET3.kicad_pcb, power-input.sch]
2020-12-24 Fix I2C Address selection to support up to 4 boards - Add pullups to I2C
    [FET.sch, SH-ESP32-PowerFET.kicad_pcb, SH-ESP32-PowerFET.sch]
2020-12-25 Tidy Planes on back side - Change I2C header to Socket for HAT connection to SH_ESP32
    [SH-ESP32-PowerFET.kicad_pcb, SH-ESP32-PowerFET.sch]
2020-12-25 Change Buck PSU for a LDO Regulator - Allowed input from VIN-Protected from SH-ESP32 when in HAT mode. (2 pin socket). - Saves wiring and sockets etc. - Shoved ScrewTerminal to permit VIN-Prot header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
    [FET.sch, SH-ESP32-PowerFET.kicad_pcb, SH-ESP32-PowerFET.sch, power-input.sch]
