markfarnan/yacht_hardware/(notices)

Notices in the files:
SH-ESP32-PowerFET/SH-ESP32-PowerFET3.kicad_pcb:
Sailor Hat for ESP32 is licensed under CC BY-SA 4.0.
SH-ESP32-PowerFET/FET.sch:
https://creativecommons.org/licenses/by-sa/4.0
Opto-Tacho/PCB.sch:
Ethernet Top-Hat for SH-ESP32 is licensed under CC BY-SA 4.0.
